zoonman/ssb85/README.md

# ssb85
My work-in-progress hamradio transceiver.

SSB85
