zoonman/ssb85/ADIMB/ADIMB.kicad_pcb

## KiCad design ADIMB/ADIMB.kicad_pcb (2019-08-25)

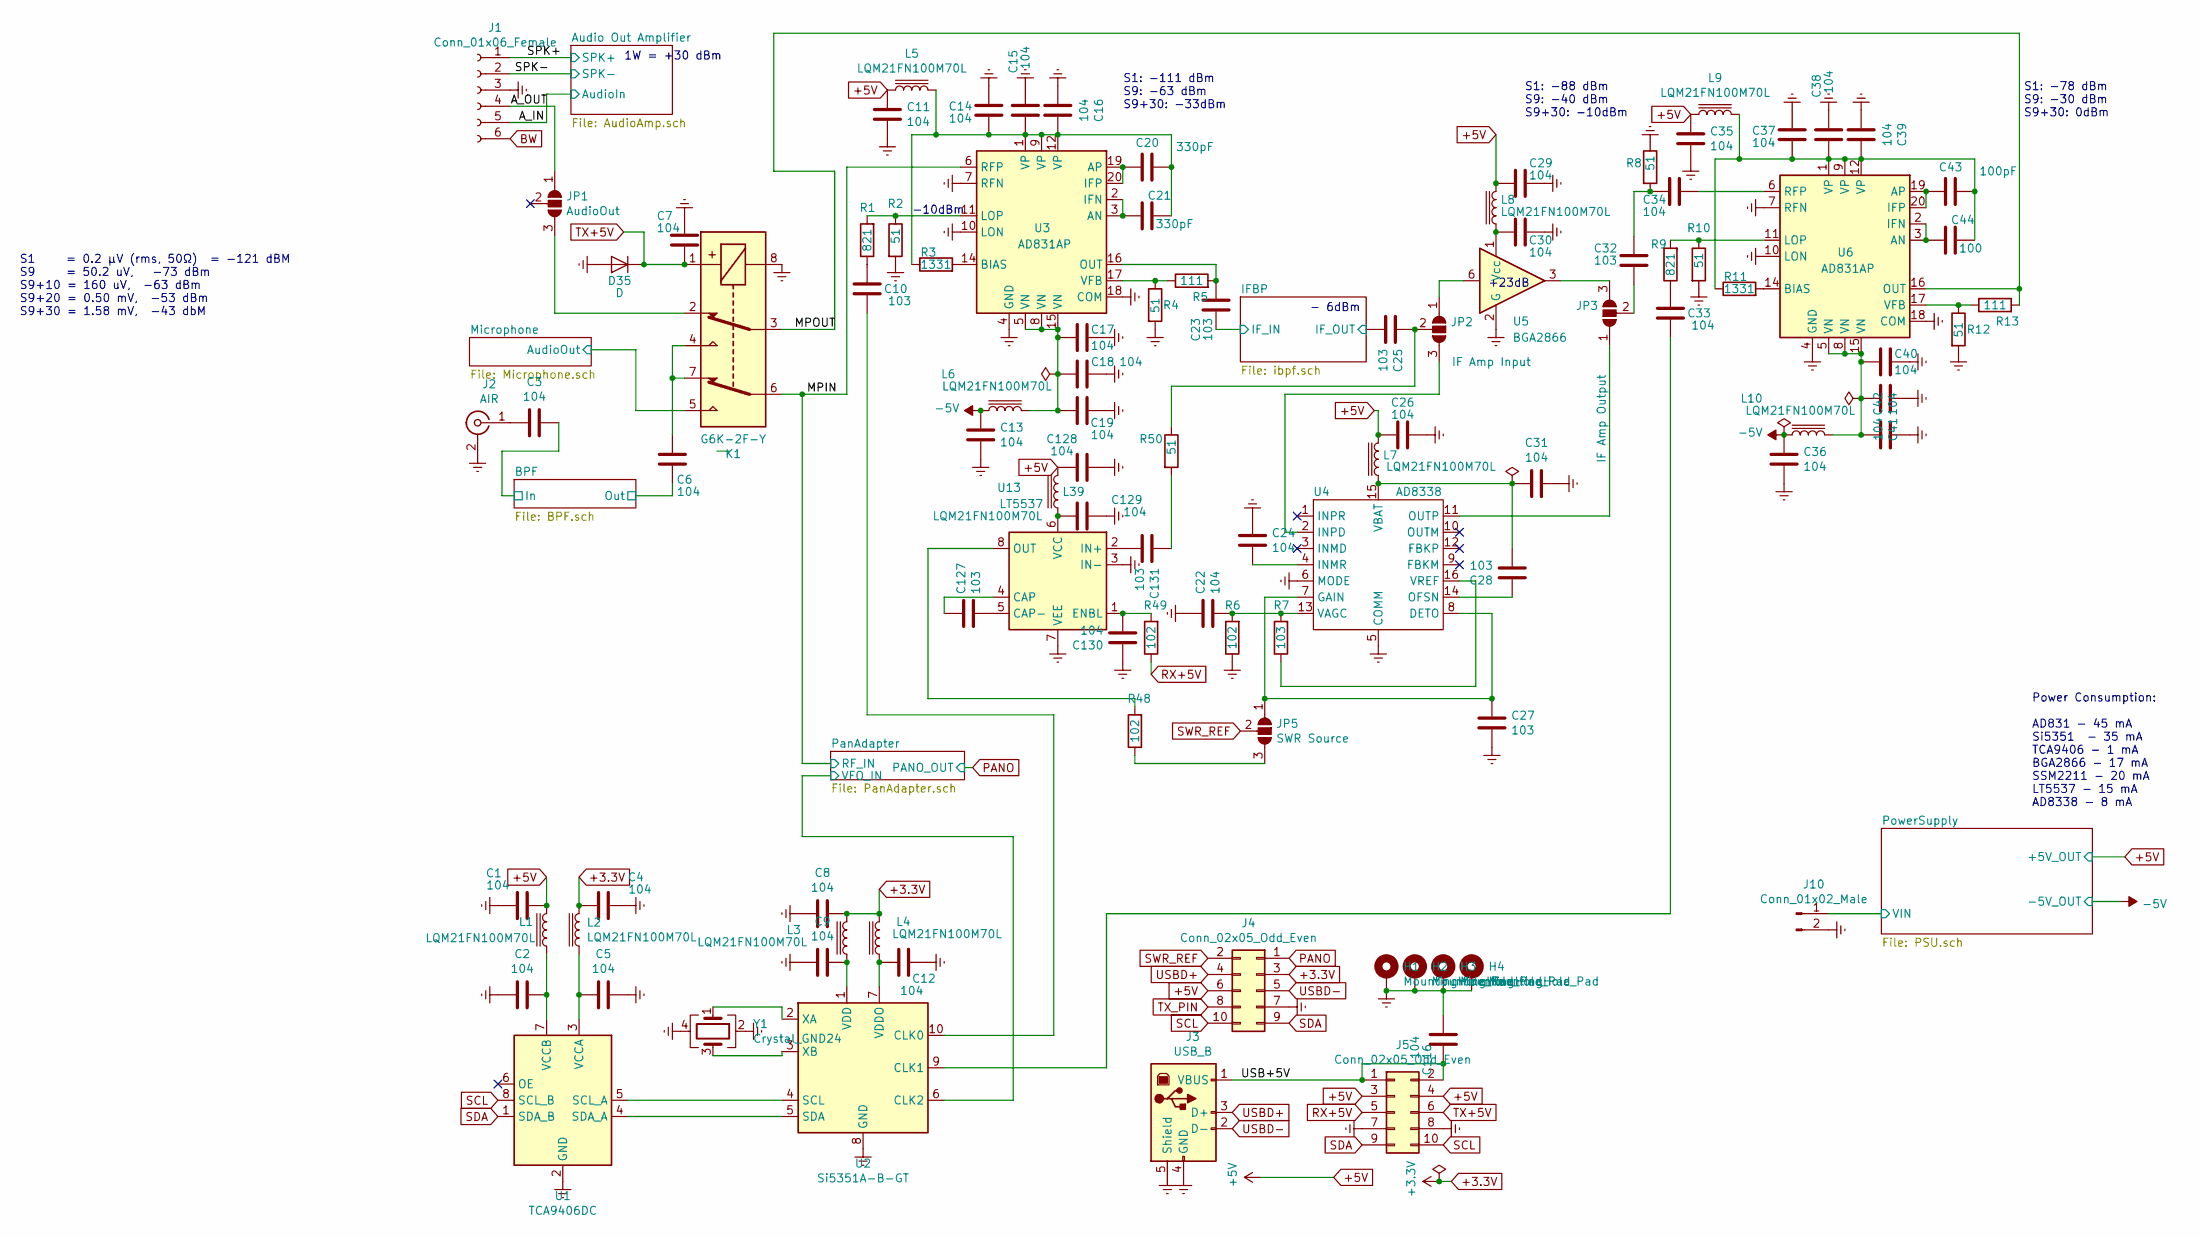
[picture p1: schematic ADIMB.sch, SSB85 Transceiver Main Board]

Parts:
C1, C2, C3, C4, C5, C6, C7, C8, C9, C11, C12, C13, C14, C15, C16, C17, C18, C19, C22, C24, C26, C29, C30, C31, C33, C34, C35, C36, C37, C38, C39, C40, C41, C42, C116, C128, C129, C130: 104; C_0805_2012Metric
C10, C23, C25, C27, C28, C32, C127, C131: 103; C_0805_2012Metric
C20, C21: 330pF; C_0805_2012Metric
C43: 100pF; C_0805_2012Metric
C44: 100; C_0805_2012Metric
D35: D; D_SOD-123
H1, H2, H3, H4: MountingHole_Pad; MountingHole_3.2mm_M3_Pad_Via
J1: Conn_01x06_Female; PinSocket_1x06_P2.54mm_Horizontal
J2: AIR; SMA_Amphenol_901-144_Vertical
J3: USB_B; USB_B_OST_USB-B1HSxx_Horizontal
J4: Conn_02x05_Odd_Even; PinSocket_2x05_P2.54mm_Horizontal
J5: Conn_02x05_Odd_Even; PinSocket_2x05_P2.54mm_Vertical
J10: Conn_01x02_Male; PinHeader_1x02_P2.54mm_Vertical
JP1: AudioOut; SolderJumper-3_P1.3mm_Open_RoundedPad1.0x1.5mm
JP2: IF Amp Input; SolderJumper-3_P1.3mm_Open_RoundedPad1.0x1.5mm
JP3: IF Amp Output; SolderJumper-3_P1.3mm_Open_RoundedPad1.0x1.5mm
JP5: SWR Source; SolderJumper-3_P1.3mm_Open_RoundedPad1.0x1.5mm
K1: G6K-2F-Y; Relay_DPDT_Omron_G6K-2F-Y
L1, L2, L3, L4, L5, L6, L7, L8, L9, L10, L39: LQM21FN100M70L; L_0805_2012Metric
R1, R9: 821; R_0805_2012Metric
R2, R4, R8, R10, R12, R50: 51; R_0805_2012Metric
R3, R11: 1331; R_0805_2012Metric
R5, R13: 111; R_0805_2012Metric
R6, R48, R49: 102; R_0805_2012Metric
R7: 103; R_0805_2012Metric
U1: TCA9406DC; VSSOP-8_2.3x2mm_P0.5mm
U2: Si5351A-B-GT; MSOP-10_3x3mm_P0.5mm
U3, U6: AD831AP; PLCC-20
U4: AD8338; LFCSP-16-1EP_3x3mm_P0.5mm_EP1.7x1.7mm
U5: BGA2866; SOT-363_SC-70-6
U13: LT5537; DFN-8-1EP_2x3mm_P0.5mm_EP0.61x2.2mm
Y1: Crystal_GND24; Crystal_SMD_Abracon_ABM8G-4Pin_3.2x2.5mm

Connections:
+3.3V: C4.2, C8.1, J4.3, L2.2, L3.2, L4.2
+5V: C1.1, C11.1, C26.2, C29.2, C35.1, C128.2, J4.6, J5.3, J5.4, L1.2, L5.1, L7.2, L8.2, L9.1, L39.2; also elsewhere on the board
-5V: C13.1, C36.1, L6.1, L10.1; also elsewhere on the board
/A_IN: J1.5; also elsewhere on the board
/A_OUT: J1.4, JP1.1 (A)
/BPF/In: C3.1; also elsewhere on the board
/BPF/Out: C6.1; also elsewhere on the board
/IFBP/IF_IN: C23.1; also elsewhere on the board
/IFBP/IF_OUT: C25.2; also elsewhere on the board
/MPIN: K1.6, U3.6 (RFP); also elsewhere on the board
/MPOUT: K1.3, R13.2, U6.16 (OUT)
/Microphone/AudioOut: K1.5; also elsewhere on the board
/PanAdapter/VFO_IN: U2.6 (CLK2); also elsewhere on the board
/PowerSupply/VIN: J10.1; also elsewhere on the board
/SPK+: J1.1; also elsewhere on the board
/SPK-: J1.2; also elsewhere on the board
/USB+5V: C116.1, J3.1 (VBUS), J5.1, J5.2
BW: J1.6; also elsewhere on the board
Earth: C1.2, C2.2, C4.1, C5.1, C7.1, C8.2, C9.2, C11.2, C12.1, C13.2, C14.2, C15.2, C16.2, C17.1, C18.1, C19.2, C22.1, C24.1, C26.1, C27.2, C29.1, C30.1, C31.1, C35.2, C36.2, C37.2, C38.2, C39.2, C40.1, C41.1, C42.2, C116.2, C128.1, C129.1, C130.1, D35.2 (A), H1.1, H2.1, H3.1, H4.1, J1.3, J2.2 (Ext), J3.4 (GND), J3.5 (Shield), J4.7, J5.7, J5.8, J10.2, K1.8, R2.2, R4.2, R6.1, R8.1, R10.2, R12.2, U1.2 (GND), U2.8 (GND), U3.4 (GND), U3.7 (RFN), U3.10 (LON), U3.13 (GND), U3.18 (COM), U4.5 (COMM), U4.6 (MODE), U4.17 (EPAD), U5.2 (G), U5.4 (G), U5.5 (G), U6.4 (GND), U6.7 (RFN), U6.10 (LON), U6.13 (GND), U6.18 (COM), U13.3 (IN-), U13.7 (VEE), U13.9 (PAD), Y1.2, Y1.4; also elsewhere on the board
unnamed: C2.1, L1.1, U1.7 (VCCB)
unnamed: C3.2, J2.1 (In)
unnamed: C5.2, L2.1, U1.3 (VCCA)
unnamed: C6.2, K1.4, K1.7
unnamed: C9.1, L3.1, U2.1 (VDD)
unnamed: C10.1, R1.1
unnamed: C10.2, U2.10 (CLK0)
unnamed: C12.2, L4.1, U2.7 (VDDO)
unnamed: C14.1, C15.1, C16.1, C20.1, C21.1, L5.2, R3.1, U3.1 (VP), U3.9 (VP), U3.12 (VP)
unnamed: C17.2, C18.2, C19.1, L6.2, U3.5 (VN), U3.8 (VN), U3.15 (VN)
unnamed: C20.2, U3.19 (AP), U3.20 (IFP)
unnamed: C21.2, U3.2 (IFN), U3.3 (AN)
unnamed: C22.2, R6.2, R7.2, U4.13 (VAGC)
unnamed: C23.2, R5.2, U3.16 (OUT)
unnamed: C24.2, U4.4 (INMR)
unnamed: C25.1, JP2.2 (C), R50.1
unnamed: C27.1, JP5.1 (A), U4.7 (GAIN), U4.8 (DETO)
unnamed: C28.1, U4.14 (OFSN)
unnamed: C28.2, C31.2, L7.1, U4.15 (VBAT)
unnamed: C30.2, L8.1, U5.1 (Vcc)
unnamed: C32.1, JP3.2 (C)
unnamed: C32.2, C34.2, R8.2
unnamed: C33.1, R9.1
unnamed: C33.2, U2.9 (CLK1)
unnamed: C34.1, U6.6 (RFP)
unnamed: C37.1, C38.1, C39.1, C43.1, C44.1, L9.2, R11.1, U6.1 (VP), U6.9 (VP), U6.12 (VP)
unnamed: C40.2, C41.2, C42.1, L10.2, U6.5 (VN), U6.8 (VN), U6.15 (VN)
unnamed: C43.2, U6.19 (AP), U6.20 (IFP)
unnamed: C44.2, U6.2 (IFN), U6.3 (AN)
unnamed: C127.1, U13.4 (CAP)
unnamed: C127.2, U13.5 (CAP-)
unnamed: C129.2, L39.1, U13.6 (VCC)
unnamed: C130.2, R49.2, U13.1 (ENBL)
unnamed: C131.1, R50.2
unnamed: C131.2, U13.2 (IN+)
unnamed: JP1.3 (B), K1.2
unnamed: JP2.1 (A), U5.6
unnamed: JP2.3 (B), U4.2 (INPD)
unnamed: JP3.1 (A), U4.11 (OUTP)
unnamed: JP3.3 (B), U5.3
unnamed: JP5.3 (B), R48.1
unnamed: R1.2, R2.1, U3.11 (LOP)
unnamed: R3.2, U3.14 (BIAS)
unnamed: R4.1, R5.1, U3.17 (VFB)
unnamed: R7.1, U4.16 (VREF)
unnamed: R9.2, R10.1, U6.11 (LOP)
unnamed: R11.2, U6.14 (BIAS)
unnamed: R12.1, R13.1, U6.17 (VFB)
unnamed: R48.2, U13.8 (OUT)
unnamed: U1.4 (SDA_A), U2.5 (SDA)
unnamed: U1.5 (SCL_A), U2.4 (SCL)
unnamed: U2.2 (XA), Y1.1
unnamed: U2.3 (XB), Y1.3
PANO: J4.1; also elsewhere on the board
RX+5V: J5.5, R49.1; also elsewhere on the board
SCL: J4.10, J5.10, U1.8 (SCL_B); also elsewhere on the board
SDA: J4.9, J5.9, U1.1 (SDA_B); also elsewhere on the board
SWR_REF: J4.2, JP5.2 (C)
TX+5V: C7.2, D35.1 (K), J5.6, K1.1; also elsewhere on the board
TX_PIN: J4.8; also elsewhere on the board
USBD+: J3.3 (D+), J4.4
USBD-: J3.2 (D-), J4.5

Notes on the sheet:
S1 = 0.2 μV (rms, 50Ω) = -121 dBM S9 = 50.2 uV, -73 dBm S9+10 = 160 uV, -63 dBm S9+20 = 0.50 mV, -53 dBm S9+30 = 1.58 mV, -43 dbM
1W = +30 dBm
S1: -111 dBm S9: -63 dBm S9+30: -33dBm
-10dBm
- 6dBm
+23dB
S1: -88 dBm S9: -40 dBm S9+30: -10dBm
S1: -78 dBm S9: -30 dBm S9+30: 0dBm
Power Consumption: AD831 - 45 mA Si5351 - 35 mA TCA9406 - 1 mA BGA2866 - 17 mA SSM2211 - 20 mA LT5537 - 15 mA AD8338 - 8 mA

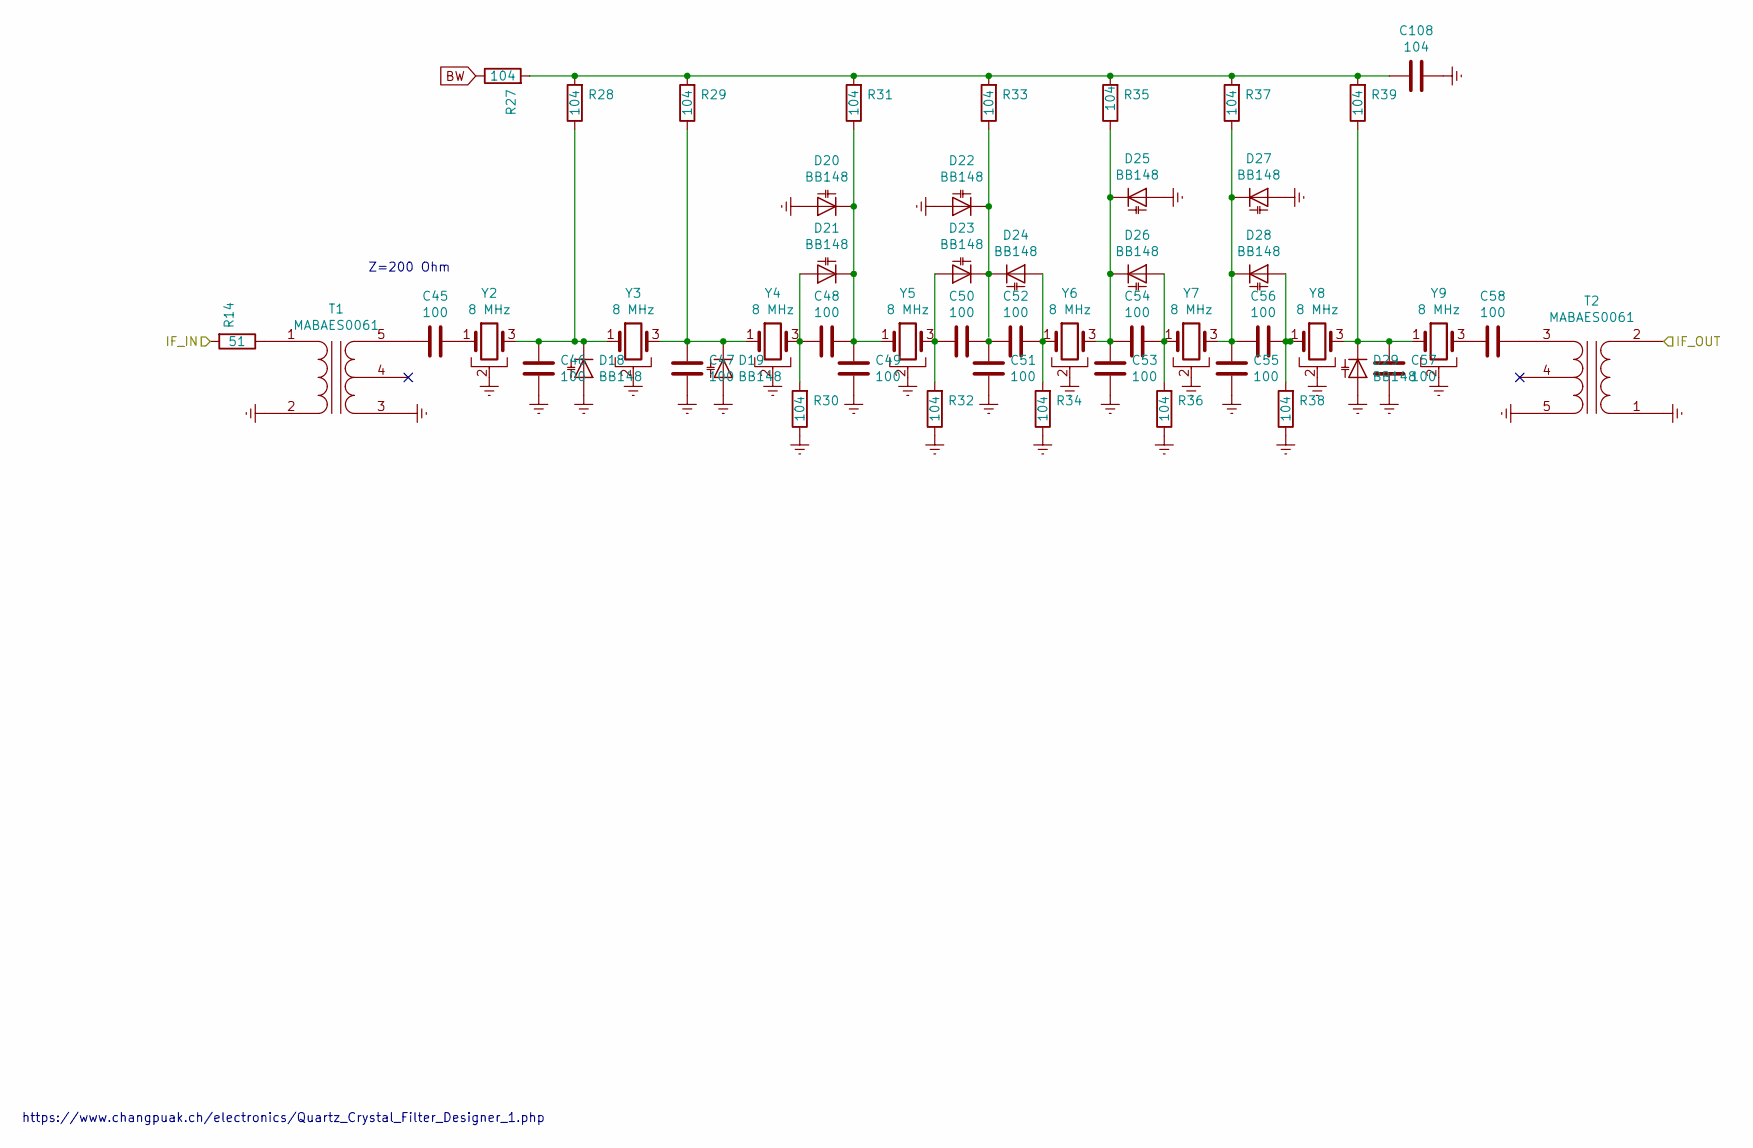
[picture p2: schematic ibpf.sch, SSB85 Transceiver]

Parts:
C45, C46, C47, C48, C49, C50, C51, C52, C53, C54, C55, C56, C57, C58: 100; C_0805_2012Metric
C108: 104; C_0805_2012Metric
D18: BB148; D_SOD-323
D19, D20, D21, D22, D23, D24, D25, D26, D27, D28, D29: BB148; D_SOD-323_HandSoldering
R14: 51; R_0805_2012Metric
R27, R28, R29, R30, R31, R32, R33, R34, R35, R36, R37, R38, R39: 104; R_0805_2012Metric
T1, T2: MABAES0061; Transformer_MACOM_SM-22
Y2, Y3, Y4, Y5, Y6, Y7, Y8, Y9: 8 MHz; Crystal_HC49-U-3Pin_Vertical

Connections:
/IFBP/IF_IN: R14.2; also elsewhere on the board
/IFBP/IF_OUT: T2.2 (AB); also elsewhere on the board
BW: R27.1; also elsewhere on the board
Earth: C46.1, C47.1, C49.1, C51.1, C53.1, C55.1, C57.1, C108.1, D18.2 (A), D19.2 (A), D20.2 (A), D22.2 (A), D25.2 (A), D27.2 (A), D29.2 (A), R30.1, R32.1, R34.1, R36.1, R38.1, T1.2 (AB), T1.3 (SA), T2.1 (AA), T2.5 (SB), Y2.2, Y3.2, Y4.2, Y5.2, Y6.2, Y7.2, Y8.2, Y9.2; also elsewhere on the board
unnamed: C45.1, Y2.1
unnamed: C45.2, T1.5 (SB)
unnamed: C46.2, D18.1 (K), R28.1, Y2.3, Y3.1
unnamed: C47.2, D19.1 (K), R29.1, Y3.3, Y4.1
unnamed: C48.1, C49.2, D20.1 (K), D21.1 (K), R31.1, Y5.1
unnamed: C48.2, D21.2 (A), R30.2, Y4.3
unnamed: C50.1, C51.2, C52.2
unnamed: C50.2, D23.2 (A), R32.2, Y5.3
unnamed: C52.1, D24.2 (A), R34.2, Y6.1
unnamed: C53.2, C54.2, D25.1 (K), D26.1 (K), R35.1, Y6.3
unnamed: C54.1, D26.2 (A), R36.2, Y7.1
unnamed: C55.2, C56.2, D27.1 (K), D28.1 (K), R37.1, Y7.3
unnamed: C56.1, D28.2 (A), R38.2, Y8.1
unnamed: C57.2, D29.1 (K), R39.1, Y8.3, Y9.1
unnamed: C58.1, T2.3 (SA)
unnamed: C58.2, Y9.3
unnamed: C108.2, R27.2, R28.2, R29.2, R31.2, R33.2, R35.2, R37.2, R39.2
unnamed: D22.1 (K), D23.1 (K), D24.1 (K), R33.1
unnamed: R14.1, T1.1 (AA)

Notes on the sheet:
Z=200 Ohm
https://www.changpuak.ch/electronics/Quartz_Crystal_Filter_Designer_1.php

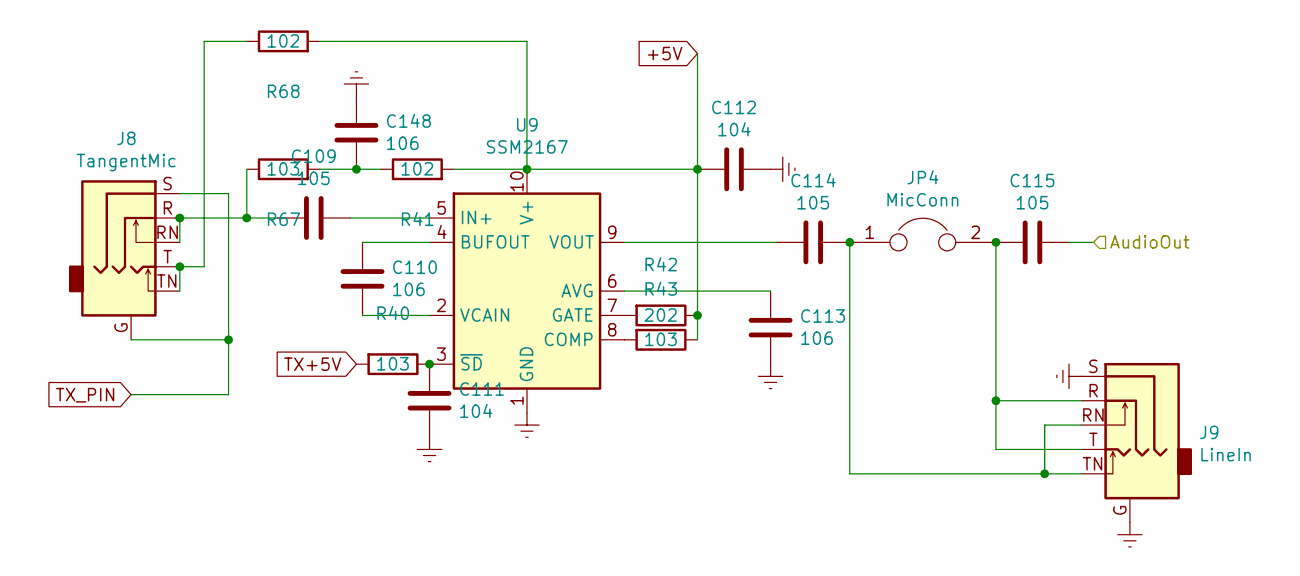
[picture p3: schematic Microphone.sch, SSB85 Transceiver]

Parts:
C109, C114, C115: 105; C_0805_2012Metric
C110, C113, C148: 106; C_0805_2012Metric
C111, C112: 104; C_0805_2012Metric
J8: TangentMic; Jack_3.5mm_PJ342_Horizontal2
J9: LineIn; Jack_3.5mm_PJ342_Horizontal2
JP4: MicConn; SolderJumper-2_P1.3mm_Open_RoundedPad1.0x1.5mm
R40, R43, R67: 103; R_0805_2012Metric
R41, R68: 102; R_0805_2012Metric
R42: 202; R_0805_2012Metric
U9: SSM2167; MSOP-10_3x3mm_P0.5mm

Connections:
+5V: C112.1, R41.2, R42.1, R43.1, R68.2, U9.10 (V+); also elsewhere on the board
/Microphone/AudioOut: C115.1; also elsewhere on the board
Earth: C111.1, C112.2, C113.2, C148.1, J9.G, J9.S, U9.1 (GND); also elsewhere on the board
unnamed: C109.1, U9.5 (IN+)
unnamed: C109.2, J8.R, J8.RN, R67.1
unnamed: C110.1, U9.4 (BUFOUT)
unnamed: C110.2, U9.2 (VCAIN)
unnamed: C111.2, R40.1, U9.3 (~SD)
unnamed: C113.1, U9.6 (AVG)
unnamed: C114.1, J9.RN, J9.TN, JP4.1
unnamed: C114.2, U9.9 (VOUT)
unnamed: C115.2, J9.R, J9.T, JP4.2
unnamed: C148.2, R41.1, R67.2
unnamed: J8.T, J8.TN, R68.1
unnamed: R42.2, U9.7 (GATE)
unnamed: R43.2, U9.8 (COMP)
TX+5V: R40.2; also elsewhere on the board
TX_PIN: J8.G, J8.S; also elsewhere on the board

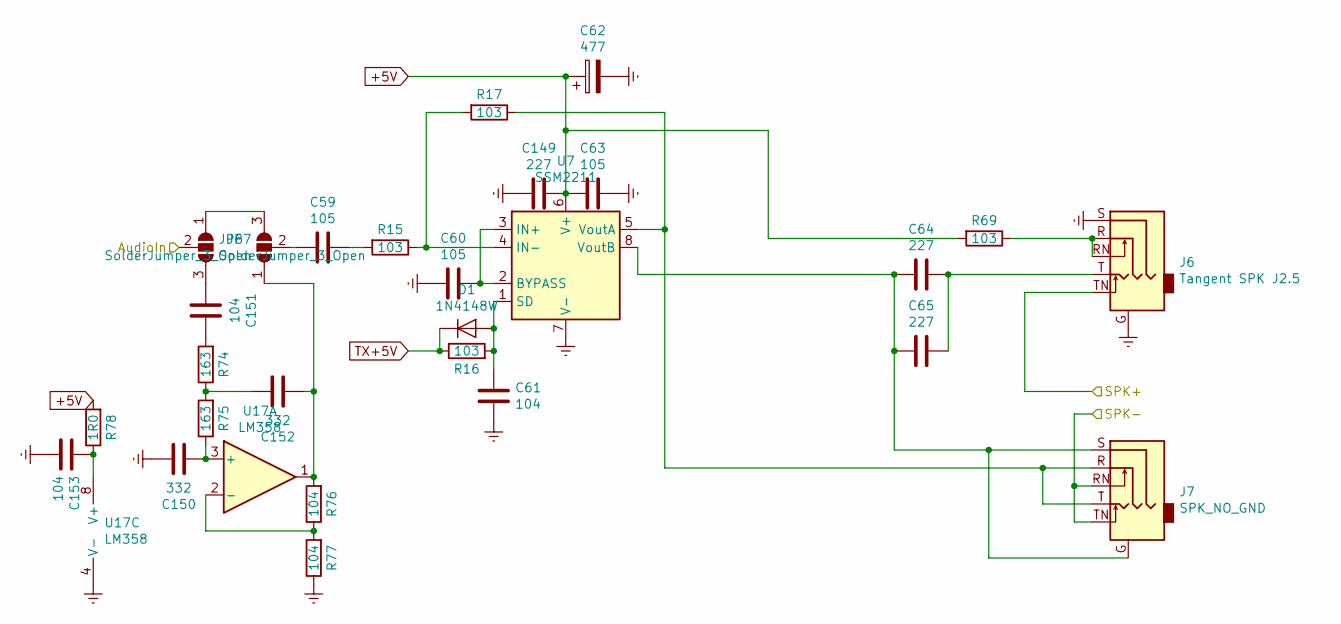
[picture p4: schematic AudioAmp.sch, SSB85 TRX Audio Amplifier]

Parts:
C59, C60, C63: 105; C_0805_2012Metric
C61, C151, C153: 104; C_0805_2012Metric
C62: 477; CP_Elec_6.3x7.7
C64, C65, C149: 227; C_1210_3225Metric
C150, C152: 332; C_0805_2012Metric
D1: 1N4148W; D_SOD-123
J6: Tangent SPK J2.5; Jack_2.5mm_PJ242_6P_12x6.2x4mm_Horizontal
J7: SPK_NO_GND; Jack_3.5mm_PJ342_Horizontal2
JP6, JP7: SolderJumper_3_Open; SolderJumper-3_P1.3mm_Open_RoundedPad1.0x1.5mm
R15, R16, R17, R69: 103; R_0805_2012Metric
R74, R75: 163; R_0805_2012Metric
R76, R77: 104; R_0805_2012Metric
R78: 1R0; R_0805_2012Metric
U7: SSM2211; SOIC-8-1EP_3.9x4.9mm_P1.27mm_EP2.29x3mm
U17: LM358; SOIC-8_3.9x4.9mm_P1.27mm

Connections:
+5V: C62.1, C63.2, C149.1, R69.2, R78.2, U7.6 (V+); also elsewhere on the board
/A_IN: JP6.2 (C); also elsewhere on the board
/SPK+: J6.TN; also elsewhere on the board
/SPK-: J7.RN, J7.TN; also elsewhere on the board
Earth: C60.2, C61.1, C62.2, C63.1, C149.2, C150.1, C153.1, J6.G, J6.S, R77.1, U7.7 (V-), U7.9 (V-), U17.4 (V-); also elsewhere on the board
unnamed: C59.1, R15.2
unnamed: C59.2, JP7.2 (C)
unnamed: C60.1, U7.2 (BYPASS), U7.3 (IN+)
unnamed: C61.2, D1.2 (A), R16.2, U7.1 (SD)
unnamed: C64.1, C65.1, J6.T
unnamed: C64.2, C65.2, J7.G, J7.S, U7.8 (VoutB)
unnamed: C150.2, R75.1, U17.3 (+)
unnamed: C151.1, R74.2
unnamed: C151.2, JP6.3 (B)
unnamed: C152.1, R74.1, R75.2
unnamed: C152.2, JP7.1 (A), R76.2, U17.1
unnamed: C153.2, R78.1, U17.8 (V+)
unnamed: J6.R, J6.RN, R69.1
unnamed: J7.R, J7.T, R17.1, U7.5 (VoutA)
unnamed: JP6.1 (A), JP7.3 (B)
unnamed: R15.1, R17.2, U7.4 (IN-)
unnamed: R76.1, R77.2, U17.2 (-)
TX+5V: D1.1 (K), R16.1; also elsewhere on the board

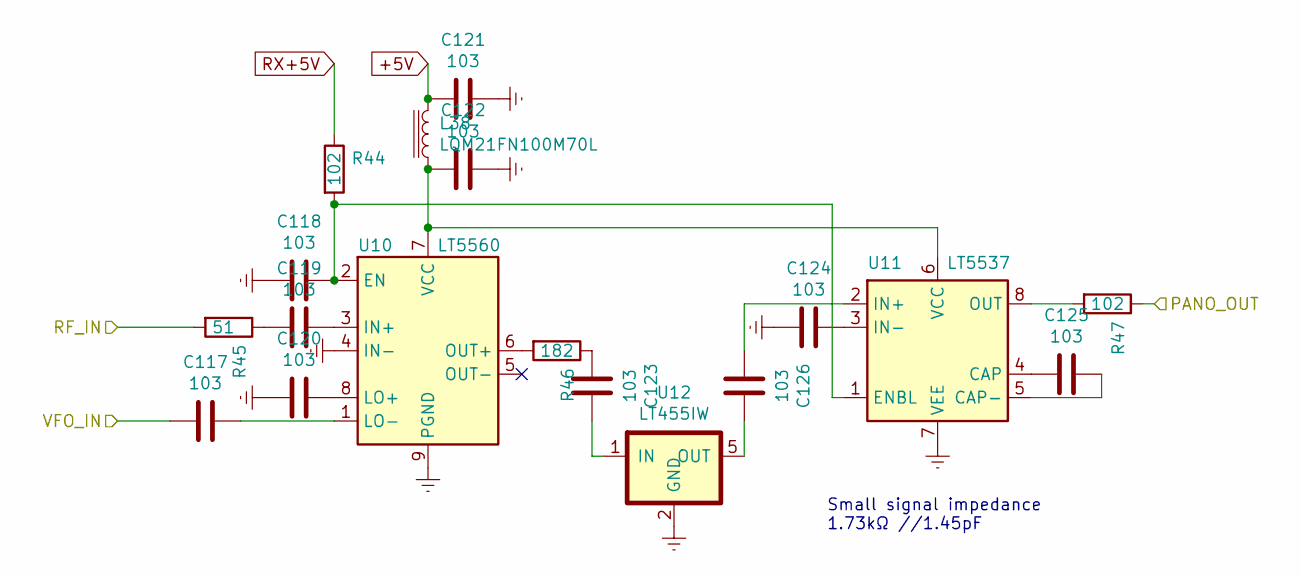
[picture p5: schematic PanAdapter.sch, SSB85 Transceiver]

Parts:
C117, C118, C119, C120, C121, C122, C123, C124, C125, C126: 103; C_0805_2012Metric
L38: LQM21FN100M70L; L_0805_2012Metric
R44, R47: 102; R_0805_2012Metric
R45: 51; R_0805_2012Metric
R46: 182; R_0805_2012Metric
U10: LT5560; DFN-8-1EP_3x3mm_P0.5mm_EP1.66x2.38mm
U11: LT5537; DFN-8-1EP_2x3mm_P0.5mm_EP0.61x2.2mm
U12: LT455IW; Filter-LT450-455-11x7

Connections:
+5V: C121.2, L38.2; also elsewhere on the board
/MPIN: R45.2; also elsewhere on the board
/PanAdapter/VFO_IN: C117.2; also elsewhere on the board
Earth: C118.2, C120.2, C121.1, C122.1, C124.2, U10.4 (IN-), U10.9 (PGND), U11.7 (VEE), U11.9 (PAD), U12.2 (GND), U12.3 (GND), U12.4 (GND); also elsewhere on the board
unnamed: C117.1, U10.1 (LO-)
unnamed: C118.1, R44.2, U10.2 (EN), U11.1 (ENBL)
unnamed: C119.1, U10.3 (IN+)
unnamed: C119.2, R45.1
unnamed: C120.1, U10.8 (LO+)
unnamed: C122.2, L38.1, U10.7 (VCC), U11.6 (VCC)
unnamed: C123.1, U12.1 (IN)
unnamed: C123.2, R46.1
unnamed: C124.1, U11.3 (IN-)
unnamed: C125.1, U11.5 (CAP-)
unnamed: C125.2, U11.4 (CAP)
unnamed: C126.1, U12.5 (OUT)
unnamed: C126.2, U11.2 (IN+)
unnamed: R46.2, U10.6 (OUT+)
unnamed: R47.2, U11.8 (OUT)
PANO: R47.1; also elsewhere on the board
RX+5V: R44.1; also elsewhere on the board

Notes on the sheet:
Small signal impedance 1.73kΩ //1.45pF

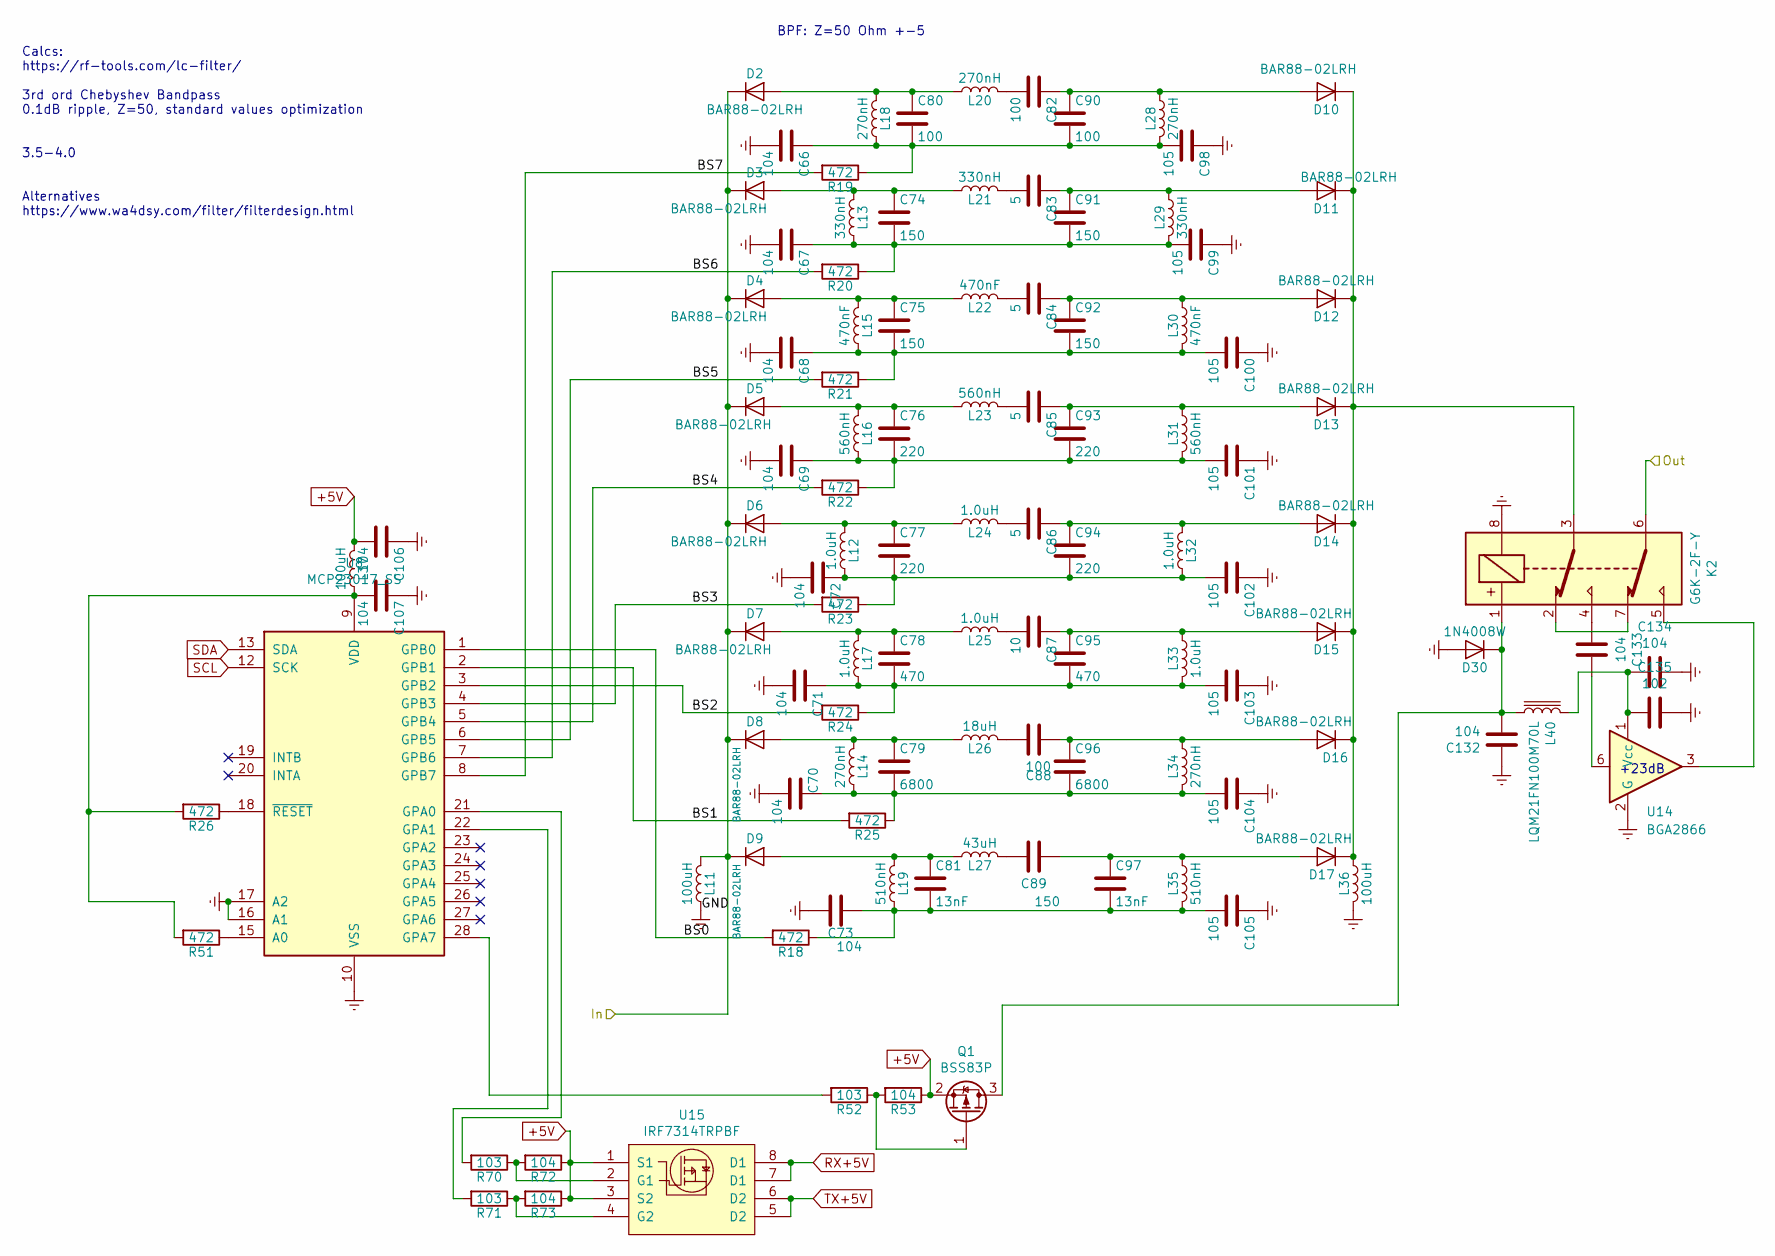
[picture p6: schematic BPF.sch, SSB85 Transceiver Band Pass Filters]

Parts:
C66, C67, C68, C69, C70, C71, C72, C73, C106, C107, C132, C133, C134: 104; C_0805_2012Metric
C74, C75, C89, C91, C92: 150; C_0805_2012Metric
C76, C77, C93, C94: 220; C_0805_2012Metric
C78, C95: 470; C_0805_2012Metric
C79, C96: 6800; C_0805_2012Metric
C80, C82, C88, C90: 100; C_0805_2012Metric
C81, C97: 13nF; C_0805_2012Metric
C83, C84, C85, C86: 5; C_0805_2012Metric
C87: 10; C_0805_2012Metric
C98, C99, C100, C101, C102, C103, C104, C105: 105; C_0805_2012Metric
C135: 102; C_0805_2012Metric
D2, D3, D4, D5, D6, D7, D8, D9, D10, D11, D12, D13, D14, D15, D16, D17: BAR88-02LRH; D_0402_1005Metric
D30: 1N4008W; D_SOD-123
K2: G6K-2F-Y; Relay_DPDT_Omron_G6K-2F-Y
L11, L36, L37: 100uH; L_0805_2012Metric
L12, L17, L24, L25, L32, L33: 1.0uH; L_0805_2012Metric
L13, L21, L29: 330nH; L_0805_2012Metric
L14, L18, L20, L28, L34: 270nH; L_0805_2012Metric
L15, L22, L30: 470nF; L_0805_2012Metric
L16, L23, L31: 560nH; L_0805_2012Metric
L19, L35: 510nH; L_0805_2012Metric
L26: 18uH; L_0805_2012Metric
L27: 43uH; L_0805_2012Metric
L40: LQM21FN100M70L; L_0805_2012Metric
Q1: BSS83P; SOT-23
R18, R19, R20, R21, R22, R23, R24, R25, R26, R51: 472; R_0805_2012Metric
R52, R70, R71: 103; R_0805_2012Metric
R53, R72, R73: 104; R_0805_2012Metric
U8: MCP23017_SS; SSOP-28_5.3x10.2mm_P0.65mm
U14: BGA2866; SOT-363_SC-70-6
U15: IRF7314TRPBF; SOIC-8_3.9x4.9mm_P1.27mm

Connections:
+5V: C106.2, L37.1, Q1.2 (S), R53.1, R72.1, R73.1, U15.1 (S1), U15.3 (S2); also elsewhere on the board
/BPF/BS0: R18.2, U8.1 (GPB0)
/BPF/BS1: R25.2, U8.2 (GPB1)
/BPF/BS2: R24.2, U8.3 (GPB2)
/BPF/BS3: R23.2, U8.4 (GPB3)
/BPF/BS4: R22.2, U8.5 (GPB4)
/BPF/BS5: R21.2, U8.6 (GPB5)
/BPF/BS6: R20.2, U8.7 (GPB6)
/BPF/BS7: R19.2, U8.8 (GPB7)
/BPF/In: D2.1 (K), D3.1 (K), D4.1 (K), D5.1 (K), D6.1 (K), D7.1 (K), D8.1 (K), D9.1 (K), L11.1; also elsewhere on the board
/BPF/Out: K2.6; also elsewhere on the board
Earth: C66.2, C67.2, C68.2, C69.2, C70.2, C71.2, C72.2, C73.2, C98.1, C99.1, C100.1, C101.1, C102.1, C103.1, C104.1, C105.1, C106.1, C107.1, C132.1, C134.1, C135.1, D30.2 (A), K2.8, L11.2, L36.2, U8.10 (VSS), U8.16 (A1), U8.17 (A2), U14.2 (G), U14.4 (G), U14.5 (G); also elsewhere on the board
unnamed: C66.1, C80.2, C90.2, C98.2, L18.2, L28.2, R19.1
unnamed: C67.1, C74.2, C91.2, C99.2, L13.2, L29.2, R20.1
unnamed: C74.1, D3.2 (A), L13.1, L21.1
unnamed: C75.1, D4.2 (A), L15.1, L22.2
unnamed: C76.1, D5.2 (A), L16.1, L23.2
unnamed: C77.1, D6.2 (A), L12.1, L24.2
unnamed: C78.1, D7.2 (A), L17.1, L25.2
unnamed: C79.1, D8.2 (A), L14.2, L26.1
unnamed: C80.1, D2.2 (A), L18.1, L20.1
unnamed: C81.1, D9.2 (A), L19.1, L27.2
unnamed: C82.1, C90.1, D10.2 (A), L28.1
unnamed: C82.2, L20.2
unnamed: C83.1, C91.1, D11.2 (A), L29.1
unnamed: C83.2, L21.2
unnamed: C84.1, C92.1, D12.2 (A), L30.1
unnamed: C84.2, L22.1
unnamed: C85.1, C93.1, D13.2 (A), L31.1
unnamed: C85.2, L23.1
unnamed: C86.1, C94.1, D14.2 (A), L32.1
unnamed: C86.2, L24.1
unnamed: C87.1, C95.1, D15.2 (A), L33.1
unnamed: C87.2, L25.1
unnamed: C88.1, C96.1, D16.2 (A), L34.1
unnamed: C88.2, L26.2
unnamed: C89.1, C97.1, D17.2 (A), L35.1
unnamed: C89.2, L27.1
unnamed: C68.1, C75.2, C92.2, C100.2, L15.2, L30.2, R21.1
unnamed: C69.1, C76.2, C93.2, C101.2, L16.2, L31.2, R22.1
unnamed: C72.1, C77.2, C94.2, C102.2, L12.2, L32.2, R23.1
unnamed: C71.1, C78.2, C95.2, C103.2, L17.2, L33.2, R24.1
unnamed: C70.1, C79.2, C96.2, C104.2, L14.1, L34.2, R25.1
unnamed: C73.1, C81.2, C97.2, C105.2, L19.2, L35.2, R18.1
unnamed: C107.2, L37.2, R26.2, R51.2, U8.9 (VDD)
unnamed: C132.2, D30.1 (K), K2.1, L40.1, Q1.3 (D)
unnamed: C133.1, U14.6
unnamed: C133.2, K2.4
unnamed: C134.2, C135.2, L40.2, U14.1 (Vcc)
unnamed: D10.1 (K), D11.1 (K), D12.1 (K), D13.1 (K), D14.1 (K), D15.1 (K), D16.1 (K), D17.1 (K), K2.3, L36.1
unnamed: K2.2, K2.7
unnamed: K2.5, U14.3
unnamed: Q1.1 (G), R52.1, R53.2
unnamed: R26.1, U8.18 (~RESET~)
unnamed: R51.1, U8.15 (A0)
unnamed: R52.2, U8.28 (GPA7)
unnamed: R70.1, R72.2, U15.2 (G1)
unnamed: R70.2, U8.21 (GPA0)
unnamed: R71.1, R73.2, U15.4 (G2)
unnamed: R71.2, U8.22 (GPA1)
RX+5V: U15.7 (D1), U15.8 (D1); also elsewhere on the board
SCL: U8.12 (SCK); also elsewhere on the board
SDA: U8.13 (SDA); also elsewhere on the board
TX+5V: U15.5 (D2), U15.6 (D2); also elsewhere on the board

Notes on the sheet:
BPF: Z=50 Ohm +-5
+23dB
Calcs: https://rf-tools.com/lc-filter/ 3rd ord Chebyshev Bandpass 0.1dB ripple, Z=50, standard values optimization 3.5-4.0 Alternatives https://www.wa4dsy.com/filter/filterdesign.html

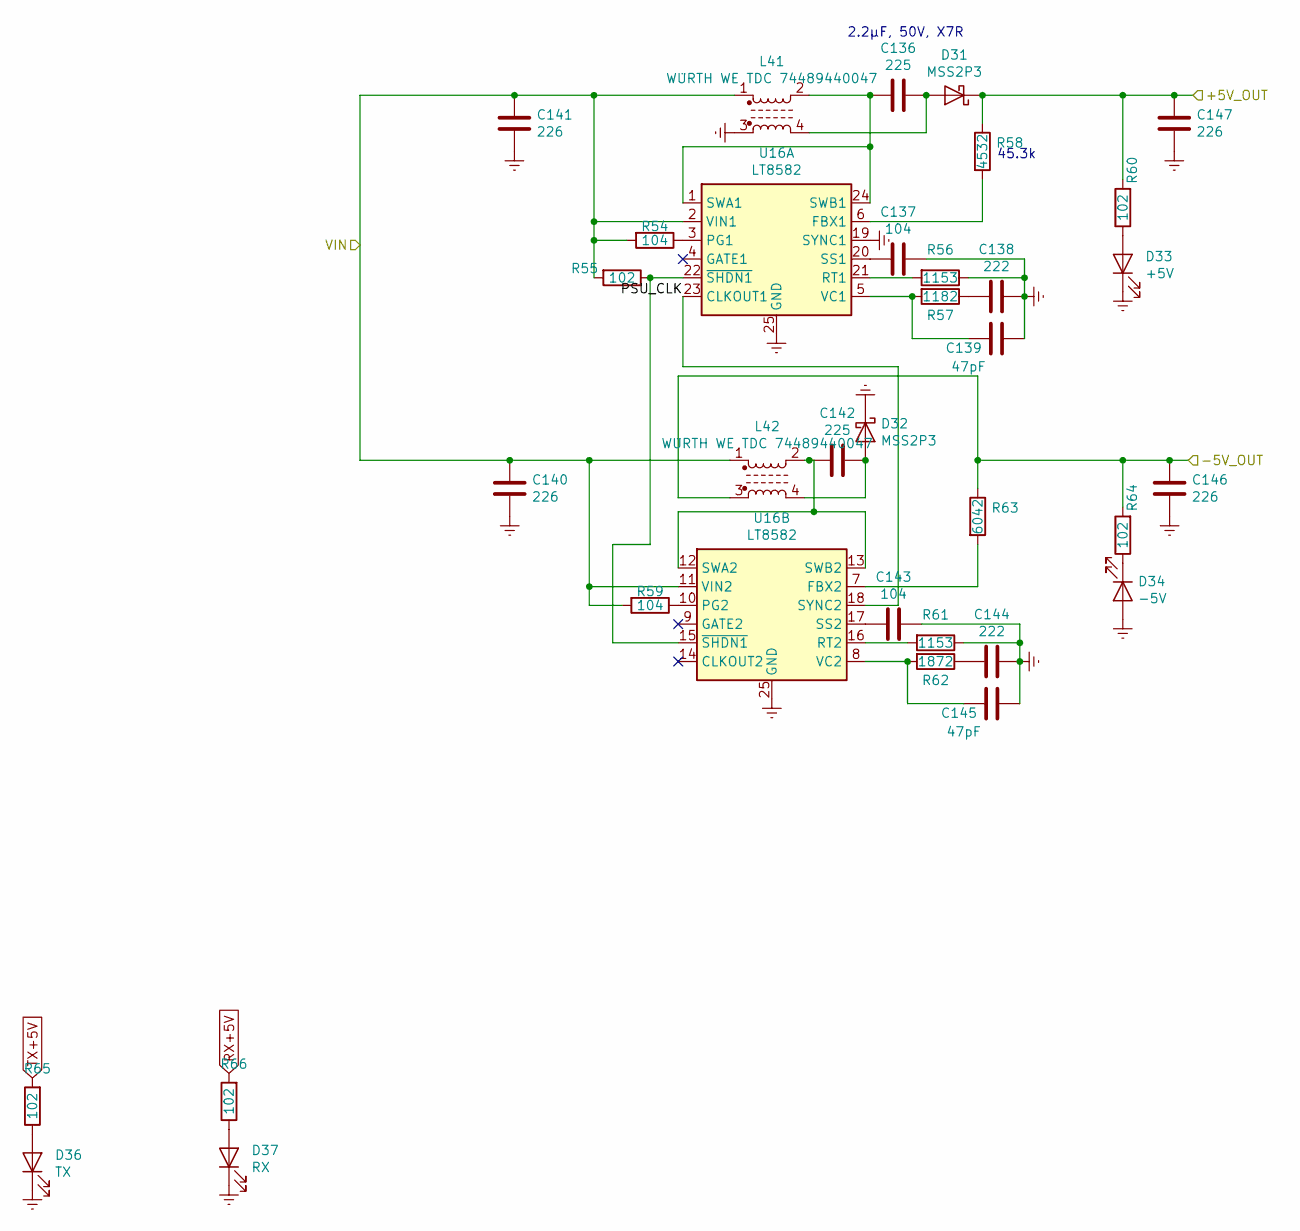
[picture p7: schematic PSU.sch, SSB85 Transceiver]

Parts:
C136, C142: 225; C_1206_3216Metric
C137, C143: 104; C_0805_2012Metric
C138, C144: 222; C_0805_2012Metric
C139, C145: 47pF; C_0805_2012Metric
C140, C141, C146, C147: 226; C_1210_3225Metric
D31, D32: MSS2P3; D_PowerDI-123
D33: +5V; D_0603_1608Metric
D34: -5V; D_0603_1608Metric
D36: TX; D_0603_1608Metric
D37: RX; D_0603_1608Metric
L41, L42: WÜRTH WE TDC 74489440047; WE-TDC-8038
R54, R59: 104; R_0805_2012Metric
R55, R60, R64, R65, R66: 102; R_0805_2012Metric
R56, R61: 1153; R_0805_2012Metric
R57: 1182; R_0805_2012Metric
R58: 4532; R_0805_2012Metric
R62: 1872; R_0805_2012Metric
R63: 6042; R_0805_2012Metric
U16: LT8582; DFN-24-1EP_4x7mm_P0.5mm_EP2.64x6.44mm

Connections:
+5V: C147.2, D31.1 (K), R58.1, R60.2; also elsewhere on the board
-5V: C146.2, L42.3, R63.1, R64.2; also elsewhere on the board
/PowerSupply/PSU_CLK: U16.18 (SYNC2), U16.23 (CLKOUT1)
/PowerSupply/VIN: C140.2, C141.2, L41.1, L42.1, R54.2, R55.2, R59.2, U16.2 (VIN1), U16.11 (VIN2); also elsewhere on the board
Earth: C137.2, C138.2, C139.2, C140.1, C141.1, C143.2, C144.2, C145.2, C146.1, C147.1, D32.1 (K), D33.1 (K), D34.2 (A), D36.1 (K), D37.1 (K), L41.3, R56.1, R61.1, U16.19 (SYNC1), U16.25 (GND); also elsewhere on the board
unnamed: C136.1, D31.2 (A), L41.4
unnamed: C136.2, L41.2, U16.1 (SWA1), U16.24 (SWB1)
unnamed: C137.1, U16.20 (SS1)
unnamed: C138.1, R57.1
unnamed: C139.1, R57.2, U16.5 (VC1)
unnamed: C142.1, D32.2 (A), L42.4
unnamed: C142.2, L42.2, U16.12 (SWA2), U16.13 (SWB2)
unnamed: C143.1, U16.17 (SS2)
unnamed: C144.1, R62.1
unnamed: C145.1, R62.2, U16.8 (VC2)
unnamed: D33.2 (A), R60.1
unnamed: D34.1 (K), R64.1
unnamed: D36.2 (A), R65.1
unnamed: D37.2 (A), R66.1
unnamed: R54.1, U16.3 (PG1)
unnamed: R55.1, U16.15 (~SHDN1), U16.22 (~SHDN1)
unnamed: R56.2, U16.21 (RT1)
unnamed: R58.2, U16.6 (FBX1)
unnamed: R59.1, U16.10 (PG2)
unnamed: R61.2, U16.16 (RT2)
unnamed: R63.2, U16.7 (FBX2)
RX+5V: R66.2; also elsewhere on the board
TX+5V: R65.2; also elsewhere on the board

Notes on the sheet:
45.3k
2.2μF, 50V, X7R
