zoonman/ssb85/ADIMB/ADIMB.kicad_pcb

## KiCad design ADIMB/ADIMB.kicad_pcb (continued)

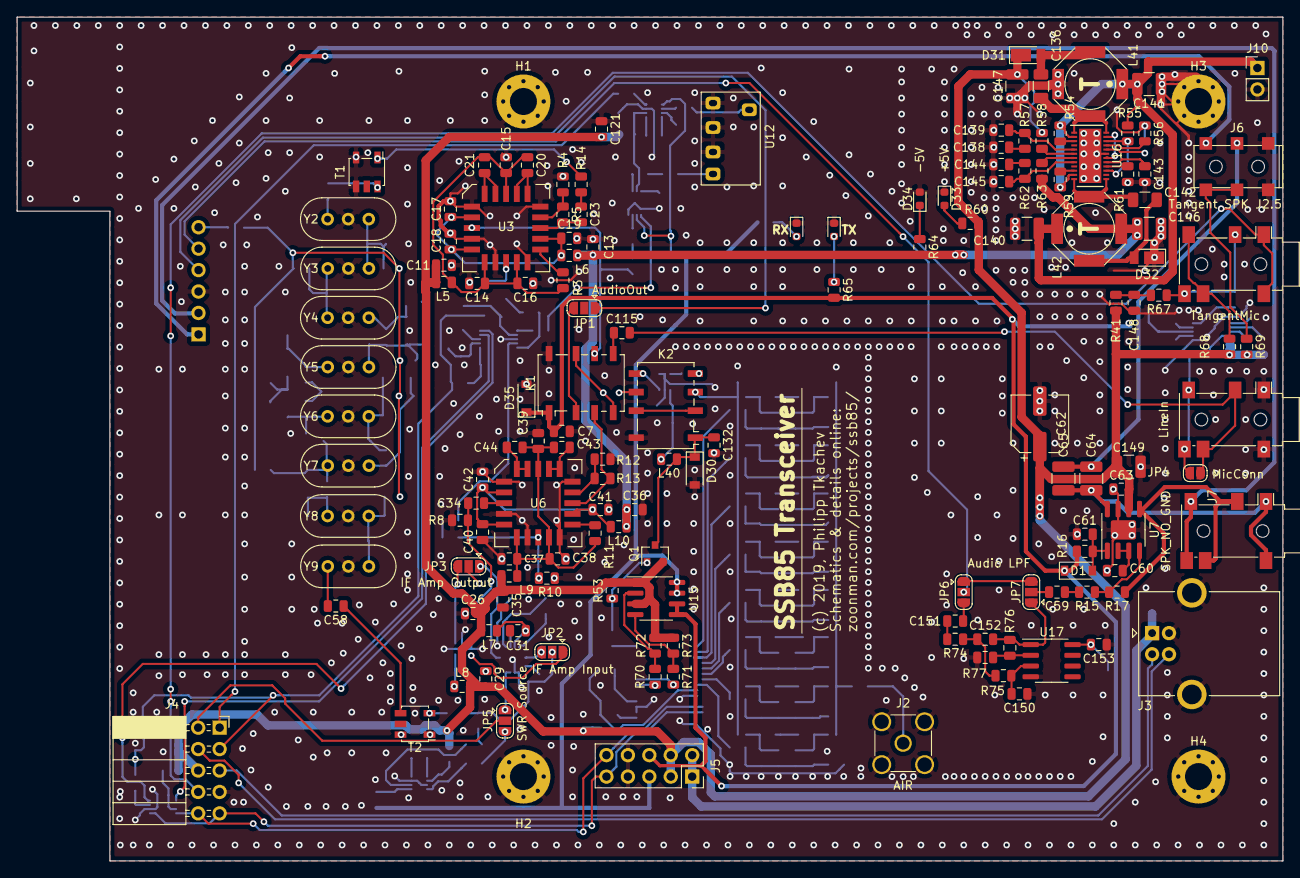
[picture p8: board ADIMB.kicad_pcb from above]

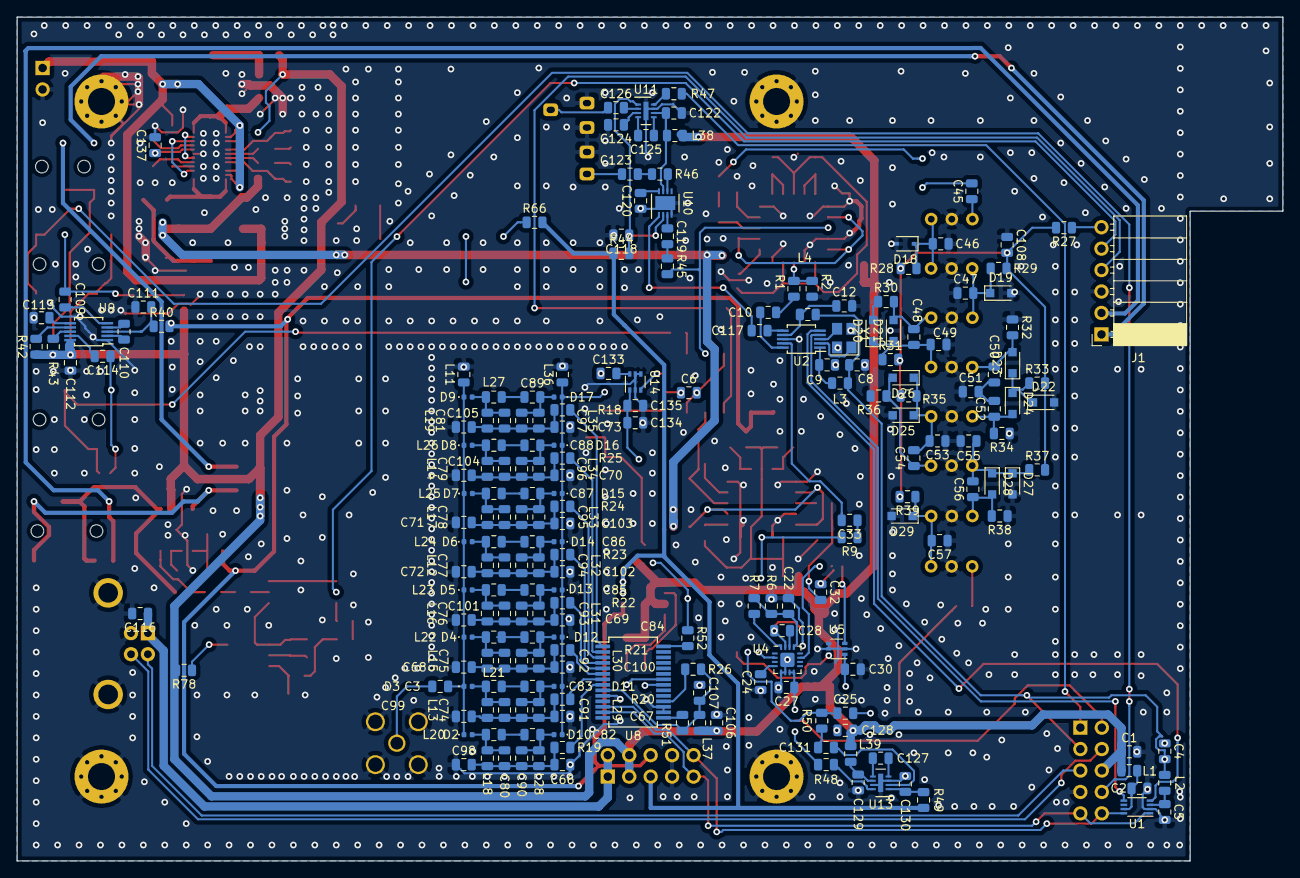
[picture p9: board ADIMB.kicad_pcb from below]

Board: 2 copper layers, 150.0 x 100.0 mm, 362 parts (213 on the bottom side), 223 nets.
