zoonman/ssb85/(notices)

Notices in the files:
ADIMB/ADIMB.kicad_pcb:
(c) 2019, Philipp Tkachev
